TheKeno/Garage_Opener_Logicer/hardware/garage_controller/placement.png

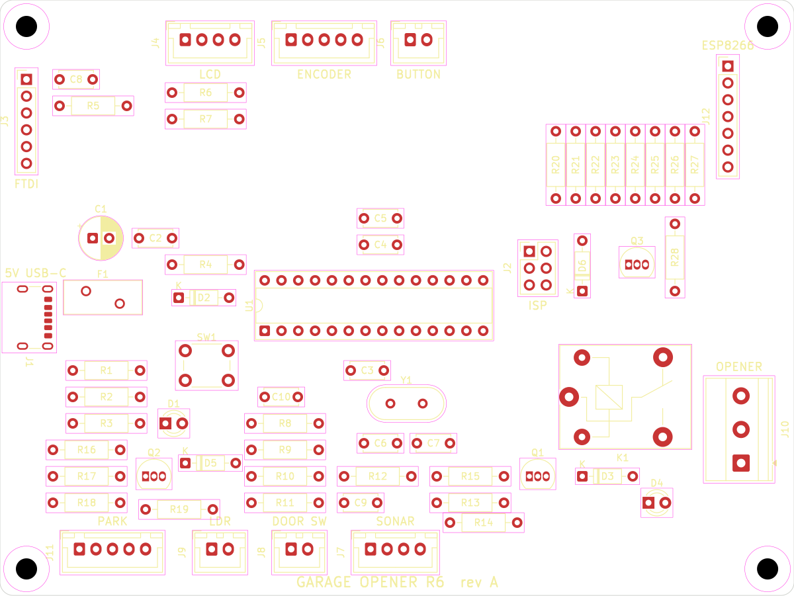
hardware/garage_controller/placement.png
