TheKeno/Garage_Opener_Logicer/hardware/garage_controller/garage_controller.pdf

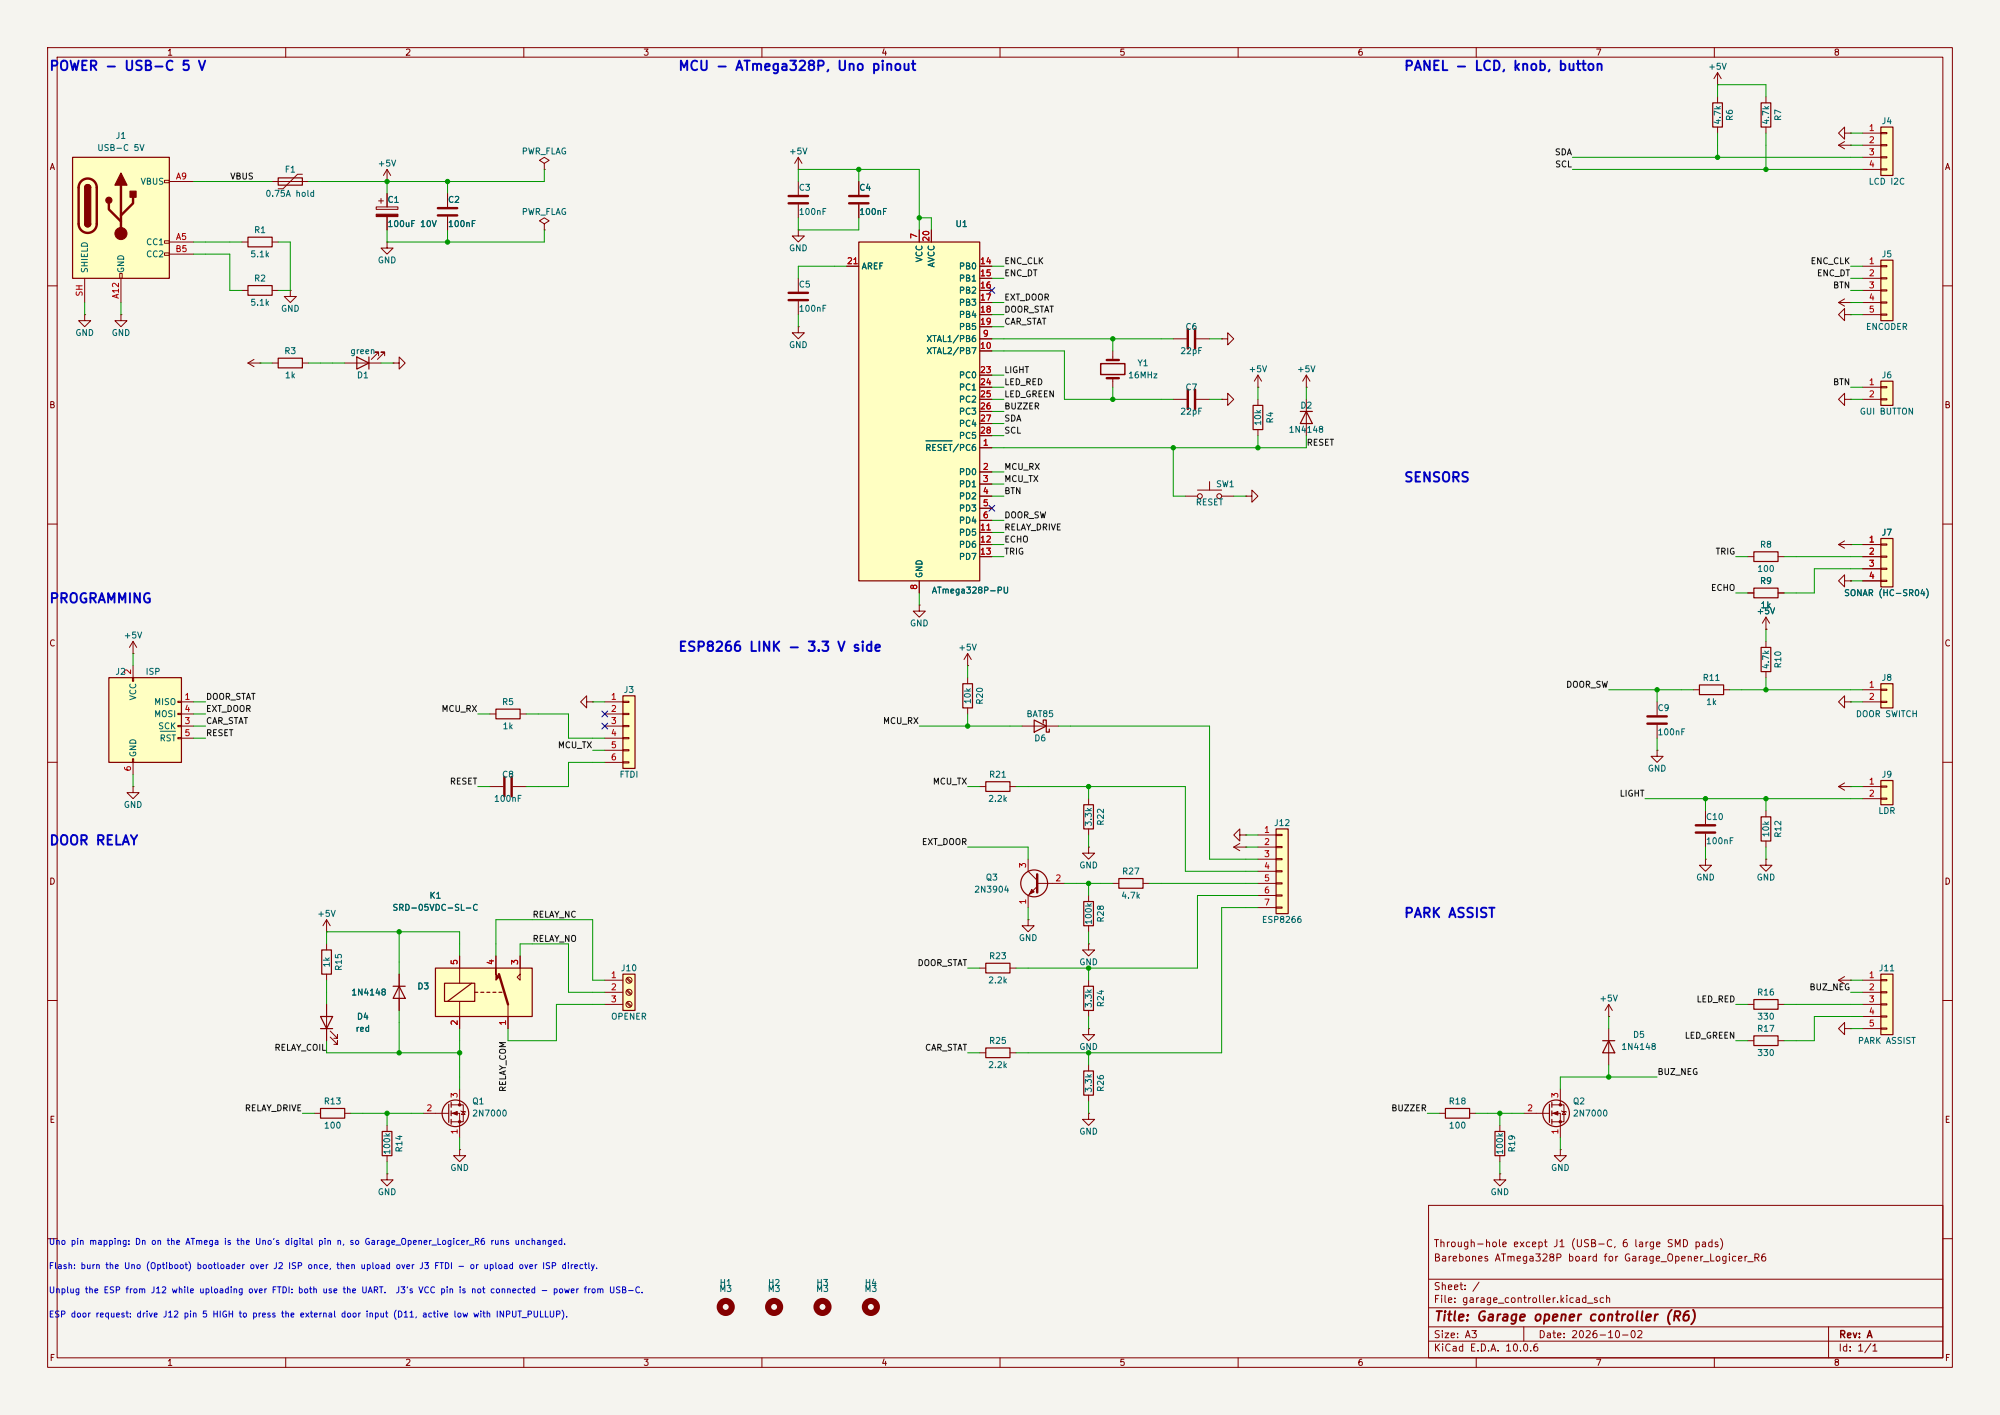
[picture p2: page 1]

Uno pin mapping: Dn on the ATmega is the Uno's digital pin n, so Garage_Opener_Logicer_R6 runs unchanged.

Flash: burn the Uno (Optiboot) bootloader over J2 ISP once, then upload over J3 FTDI - or upload over ISP directly.

Sheet: /
File: garage_controller.kicad_sch
Title: Garage opener controller (R6)

Unplug the ESP from J12 while uploading over FTDI: both use the UART. J3's VCC pin is not connected - power from USB-C. ESP door request: drive J12 pin 5 HIGH to press the external door input (D11, active low with INPUT_PULLUP).

Size: A3 | Rev: A | F Date: 2026-10-02
KiCad E.D.A. 10.0.6 | Id: 1/1
