TheKeno/Garage_Opener_Logicer/hardware/garage_controller/garage_controller.kicad_pcb

## KiCad design hardware/garage_controller/garage_controller.kicad_pcb (2026-10-02)

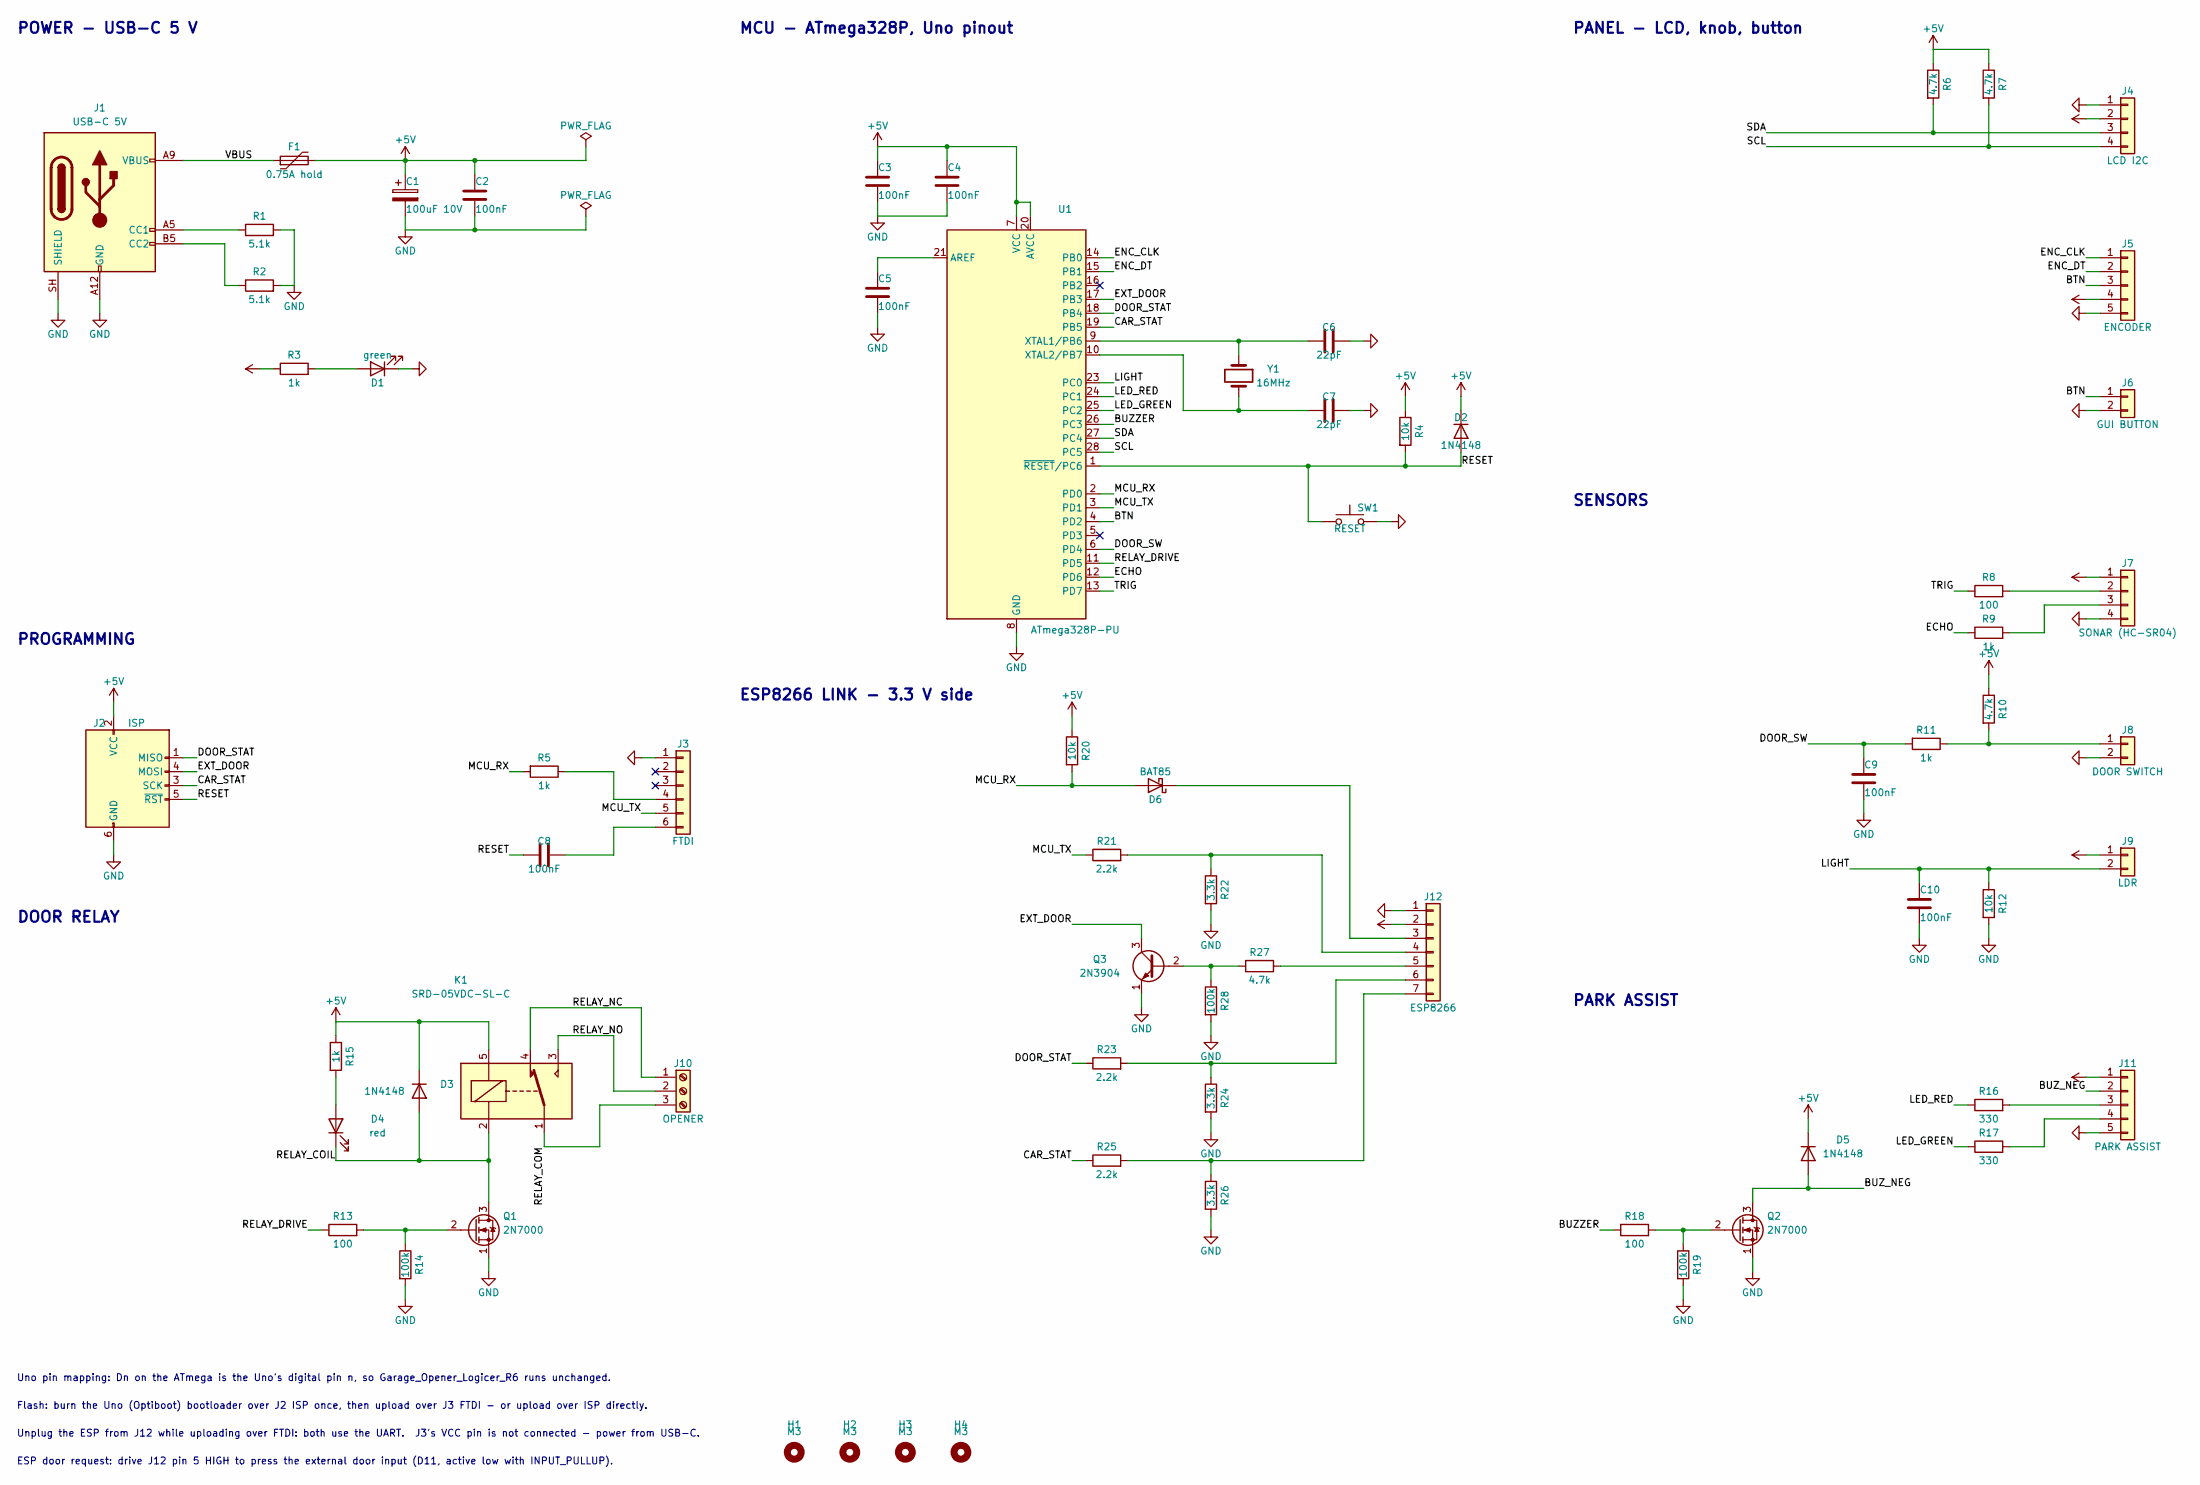
[picture p3: schematic garage_controller.kicad_sch, Garage opener controller (R6)]

Parts:
C1: 100uF 10V; CP_Radial_D6.3mm_P2.50mm
C2, C3, C4, C5, C8, C9, C10: 100nF; C_Disc_D5.0mm_W2.5mm_P5.00mm
C6, C7: 22pF; C_Disc_D5.0mm_W2.5mm_P5.00mm
D1: green; LED_D3.0mm
D2, D3, D5: 1N4148; D_DO-35_SOD27_P7.62mm_Horizontal
D4: red; LED_D3.0mm
D6: BAT85; D_DO-35_SOD27_P7.62mm_Horizontal
F1: 0.75A hold; Fuse_BelFuse_0ZRE0075FF_L11.5mm_W4.8mm
H1, H2, H3, H4: M3; MountingHole_3.2mm_M3
J1: USB-C 5V; USB_C_Receptacle_GCT_USB4125-xx-x_6P_TopMnt_Horizontal
J2: ISP; PinHeader_2x03_P2.54mm_Vertical
J3: FTDI; PinHeader_1x06_P2.54mm_Vertical
J4: LCD I2C; JST_XH_B4B-XH-A_1x04_P2.50mm_Vertical
J5: ENCODER; JST_XH_B5B-XH-A_1x05_P2.50mm_Vertical
J6: GUI BUTTON; JST_XH_B2B-XH-A_1x02_P2.50mm_Vertical
J7: SONAR (HC-SR04); JST_XH_B4B-XH-A_1x04_P2.50mm_Vertical
J8: DOOR SWITCH; JST_XH_B2B-XH-A_1x02_P2.50mm_Vertical
J9: LDR; JST_XH_B2B-XH-A_1x02_P2.50mm_Vertical
J10: OPENER; TerminalBlock_Phoenix_MKDS-1,5-3-5.08_1x03_P5.08mm_Horizont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
J11: PARK ASSIST; JST_XH_B5B-XH-A_1x05_P2.50mm_Vertical
J12: ESP8266; PinHeader_1x07_P2.54mm_Vertical
K1: SRD-05VDC-SL-C; Relay_SPDT_SANYOU_SRD_Series_Form_C
Q1, Q2: 2N7000; TO-92_Inline
Q3: 2N3904; TO-92_Inline
R1, R2: 5.1k; R_Axial_DIN0207_L6.3mm_D2.5mm_P10.16mm_Horizontal
R3, R5, R9, R11, R15: 1k; R_Axial_DIN0207_L6.3mm_D2.5mm_P10.16mm_Horizontal
R4, R12, R20: 10k; R_Axial_DIN0207_L6.3mm_D2.5mm_P10.16mm_Horizontal
R6, R7, R10, R27: 4.7k; R_Axial_DIN0207_L6.3mm_D2.5mm_P10.16mm_Horizontal
R8, R13, R18: 100; R_Axial_DIN0207_L6.3mm_D2.5mm_P10.16mm_Horizontal
R14, R19, R28: 100k; R_Axial_DIN0207_L6.3mm_D2.5mm_P10.16mm_Horizontal
R16, R17: 330; R_Axial_DIN0207_L6.3mm_D2.5mm_P10.16mm_Horizontal
R21, R23, R25: 2.2k; R_Axial_DIN0207_L6.3mm_D2.5mm_P10.16mm_Horizontal
R22, R24, R26: 3.3k; R_Axial_DIN0207_L6.3mm_D2.5mm_P10.16mm_Horizontal
SW1: RESET; SW_PUSH_6mm
U1: ATmega328P-PU; DIP-28_W7.62mm_Socket
Y1: 16MHz; Crystal_HC49-4H_Vertical

Connections:
+5V: C1.1, C2.1, C3.1, C4.1, D2.1 (K), D3.1 (K), D5.1 (K), F1.2, J2.2 (VCC), J4.2, J5.4, J7.1, J9.1, J11.1, J12.2, K1.5, R3.1, R4.1, R6.1, R7.1, R10.1, R15.1, R20.1, U1.7 (VCC), U1.20 (AVCC)
/BTN: J5.3, J6.1, U1.4 (PD2)
/BUZZER: R18.1, U1.26 (PC3)
/BUZ_NEG: D5.2 (A), J11.2, Q2.3 (D)
/CAR_STAT: J2.3 (SCK), R25.1, U1.19 (PB5)
/DOOR_STAT: J2.1 (MISO), R23.1, U1.18 (PB4)
/DOOR_SW: C9.1, R11.2, U1.6 (PD4)
/ECHO: R9.1, U1.12 (PD6)
/ENC_CLK: J5.1, U1.14 (PB0)
/ENC_DT: J5.2, U1.15 (PB1)
/EXT_DOOR: J2.4 (MOSI), Q3.3 (C), U1.17 (PB3)
/LED_GREEN: R17.1, U1.25 (PC2)
/LED_RED: R16.1, U1.24 (PC1)
/LIGHT: C10.1, J9.2, R12.1, U1.23 (PC0)
/MCU_RX: D6.2 (A), R5.2, R20.2, U1.2 (PD0)
/MCU_TX: J3.5, R21.1, U1.3 (PD1)
/RELAY_COIL: D3.2 (A), D4.1 (K), K1.2, Q1.3 (D)
/RELAY_COM: J10.3, K1.1
/RELAY_DRIVE: R13.1, U1.11 (PD5)
/RELAY_NC: J10.1, K1.4
/RELAY_NO: J10.2, K1.3
/RESET: C8.2, D2.2 (A), J2.5 (~RST), R4.2, SW1.1, U1.1 (~RESET/PC6)
/SCL: J4.4, R7.2, U1.28 (PC5)
/SDA: J4.3, R6.2, U1.27 (PC4)
/TRIG: R8.1, U1.13 (PD7)
/VBUS: F1.1, J1.A9 (VBUS), J1.B9 (VBUS)
GND: C1.2, C2.2, C3.2, C4.2, C5.2, C6.2, C7.2, C9.2, C10.2, D1.1 (K), J1.A12 (GND), J1.B12 (GND), J1.SH (SHIELD), J2.6 (GND), J3.1, J4.1, J5.5, J6.2, J7.4, J8.2, J11.5, J12.1, Q1.1 (S), Q2.1 (S), Q3.1 (E), R1.2, R2.2, R12.2, R14.2, R19.2, R22.2, R24.2, R26.2, R28.2, SW1.2, U1.8 (GND), U1.22 (GND)
unnamed: D1.2 (A), R3.2
unnamed: D4.2 (A), R15.2
unnamed: D6.1 (K), J12.3
unnamed: J1.A5 (CC1), R1.1
unnamed: J1.B5 (CC2), R2.1
unnamed: J3.4, R5.1
unnamed: C8.1, J3.6
unnamed: J7.2, R8.2
unnamed: J7.3, R9.2
unnamed: J8.1, R10.2, R11.1
unnamed: J11.3, R16.2
unnamed: J11.4, R17.2
unnamed: J12.4, R21.2, R22.1
unnamed: J12.5, R27.1
unnamed: J12.6, R23.2, R24.1
unnamed: J12.7, R25.2, R26.1
unnamed: Q1.2 (G), R13.2, R14.1
unnamed: Q2.2 (G), R18.2, R19.1
unnamed: Q3.2 (B), R27.2, R28.1
unnamed: C5.1, U1.21 (AREF)
unnamed: C6.1, U1.9 (XTAL1/PB6), Y1.1
unnamed: C7.1, U1.10 (XTAL2/PB7), Y1.2

Notes on the sheet:
MCU - ATmega328P, Uno pinout
Unplug the ESP from J12 while uploading over FTDI: both use the UART. J3's VCC pin is not connected - power from USB-C.
Uno pin mapping: Dn on the ATmega is the Uno's digital pin n, so Garage_Opener_Logicer_R6 runs unchanged.
SENSORS
PROGRAMMING
PANEL - LCD, knob, button
Flash: burn the Uno (Optiboot) bootloader over J2 ISP once, then upload over J3 FTDI - or upload over ISP directly.
ESP door request: drive J12 pin 5 HIGH to press the external door input (D11, active low with INPUT_PULLUP).
PARK ASSIST
DOOR RELAY
ESP8266 LINK - 3.3 V side
POWER - USB-C 5 V

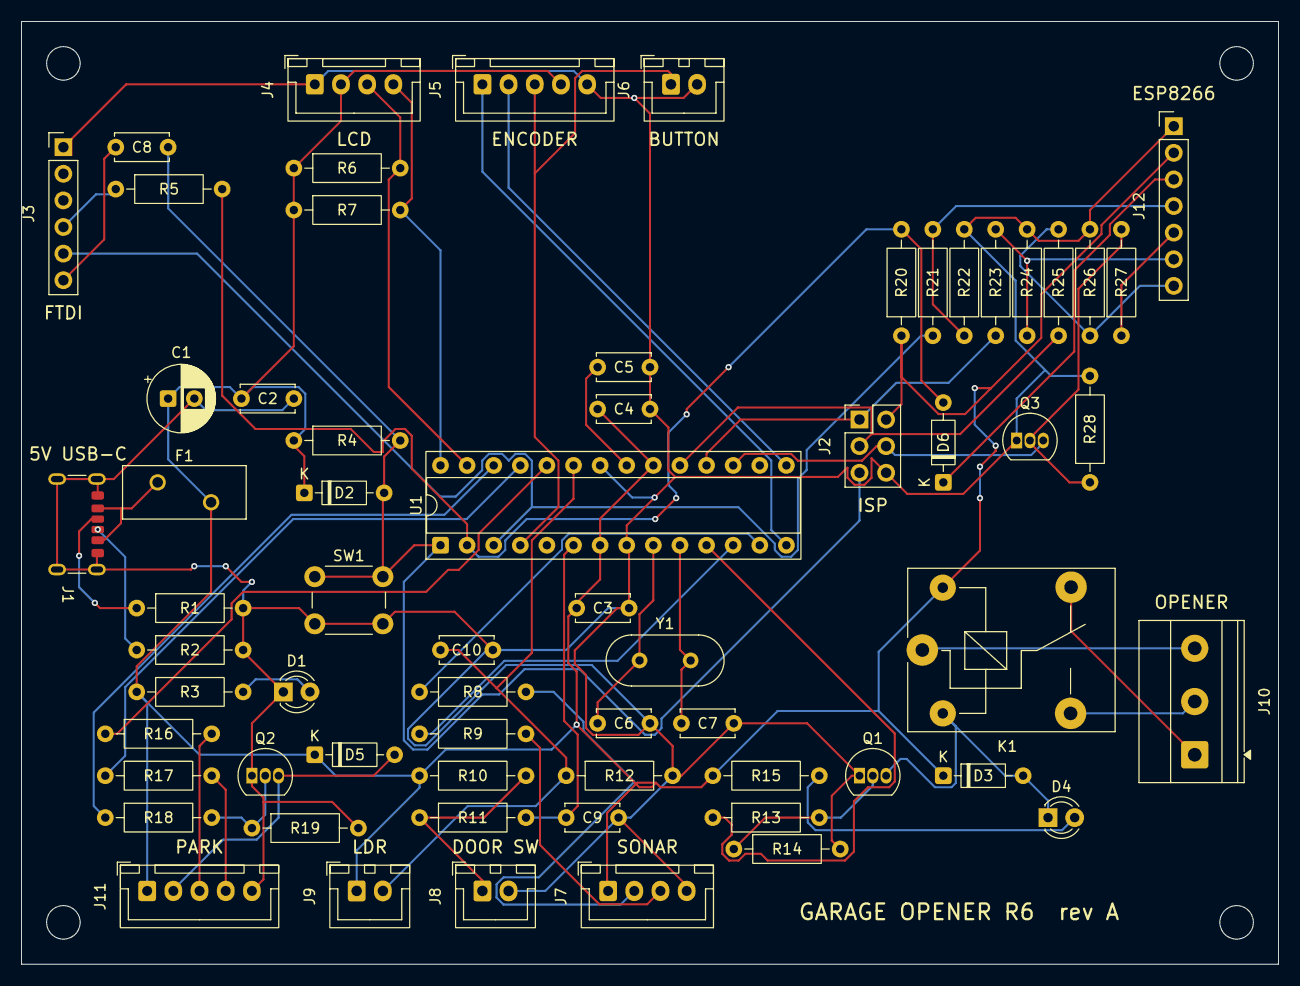
[picture p4: board garage_controller.kicad_pcb from above]

Board: 2 copper layers, 120.0 x 90.0 mm, 68 parts (0 on the bottom side), 49 nets.
