TheKeno/Garage_Opener_Logicer/Garage_Opener_Logicer_R5/Garage_Opener_Logicer_R5.ino

// Libraries
#include "Arduino.h"
#include "Button.h"

class DistanceSensor {
public:
	DistanceSensor(int trigger, int sensor) : trigger_pin(trigger), sensor_pin(sensor) {
	}
	float get_distance() {
		digitalWrite(trigger_pin, LOW);
		delayMicroseconds(2);
		
		digitalWrite(trigger_pin, HIGH);
		delayMicroseconds(10);
		digitalWrite(trigger_pin, LOW);

		unsigned long duration = pulseIn(sensor_pin, HIGH);

		return duration * SOUND_VELOCITY/2;
	}

private:
	const float SOUND_VELOCITY = 0.034;

	int trigger_pin;
	int sensor_pin;
};

enum STATES {
	STATE_IDLE,
	STATE_WAIT_FOR_DARKNESS,
	STATE_WAIT_FOR_SECOND_SIGNAL,
	STATE_OPEN_DOOR,
	STATE_CLOSE_DOOR,
};

struct StateData {
	STATES current_state;
	unsigned long entered_state_time;
};

const int trigPin = D6;
const int echoPin = D5;
const int lightPin = A0;
const int microswitchPin = D3;
const int doorPin = D4;


const int LIGHT_LEVEL_THRESHOLD = 400;
const int LIGHT_OFF_THRESHOLD = 700;
const int LIGHT_TIMEOUT = 5000;
const int DOOR_DELAY = 10000;
const int CAR_DISTANCE = 100;

Button microSwitch(microswitchPin);
DistanceSensor ultraSensor(trigPin, echoPin);


bool is_car_inside() {
	int distance = ultraSensor.get_distance();
	if(distance < CAR_DISTANCE) {
		return true;
	}

	return false;
}

bool is_door_closed() {
	return microSwitch.released();
}

void send_door_signal() {
	digitalWrite(doorPin, LOW);
	delay(10);
	digitalWrite(doorPin, HIGH);
	delay(500);
	digitalWrite(doorPin, LOW);
}

void switch_state(StateData* data, STATES new_state) {
    data->current_state = new_state;
    data->entered_state_time = millis();

    switch(new_state) {
        case STATE_OPEN_DOOR:
            Serial.println("State switch: OPEN DOOR");
            send_door_signal();
            break;

        case STATE_CLOSE_DOOR:
            Serial.println("State switch: CLOSE DOOR");
            send_door_signal();
            break;
        
        case STATE_IDLE:
            Serial.println("State switch: IDLE");
            break;

        case STATE_WAIT_FOR_DARKNESS:
            Serial.println("State switch: WAIT_FOR_DARKNESS");
            break;

        case STATE_WAIT_FOR_SECOND_SIGNAL:
            Serial.println("State switch: WAIT_FOR_SECOND_SIGNAL");
            break;

        default:
            break;
    }
}

void update_idle(StateData* data) {
	if(!is_car_inside())
		return;

	int light_level = analogRead(lightPin);
	if(light_level < LIGHT_LEVEL_THRESHOLD) {
		if(is_door_closed()) {
			switch_state(data, STATE_WAIT_FOR_SECOND_SIGNAL);
		} else {
			switch_state(data, STATE_CLOSE_DOOR);
		}
	}
}

void update_wait_for_darkness(StateData* data) {
	if(millis() > data->entered_state_time + LIGHT_TIMEOUT) {
		switch_state(data, STATE_IDLE);
		return;
	}

	int light_level = analogRead(lightPin);
	if(light_level > LIGHT_OFF_THRESHOLD) {
		switch_state(data, STATE_WAIT_FOR_SECOND_SIGNAL);
	}
}

void update_wait_for_second_signal(StateData* data) {
	if(millis() > data->entered_state_time + LIGHT_TIMEOUT) {
		switch_state(data, STATE_IDLE);
		return;
	}

	int light_level = analogRead(lightPin);
	if(light_level < LIGHT_LEVEL_THRESHOLD) {
		if(is_door_closed()) {
			switch_state(data, STATE_OPEN_DOOR);
		}
	}
}

void update_open_door(StateData* data) {
	if(millis() > data->entered_state_time + DOOR_DELAY) {
		switch_state(data, STATE_IDLE);
		return;
	}
}

void update_close_door(StateData* data) {
	if(millis() > data->entered_state_time + DOOR_DELAY) {
		switch_state(data, STATE_IDLE);
		return;
	}
}

void update(StateData* data) {
	microSwitch.read();

	switch(data->current_state) {
		case STATE_IDLE:
			update_idle(data);
			break;

		case STATE_WAIT_FOR_DARKNESS:
			update_wait_for_darkness(data);
			break;
		
		case STATE_WAIT_FOR_SECOND_SIGNAL:
			update_wait_for_second_signal(data);
			break;

		case STATE_OPEN_DOOR:
			update_open_door(data);
			break;

		case STATE_CLOSE_DOOR:
			update_close_door(data);
			break;
	}

	delay(10);
}


StateData data;
unsigned long time_of_last_print = 0;

void setup() {
	data.current_state = STATE_IDLE;

	pinMode(trigPin, OUTPUT);
	pinMode(echoPin, INPUT);
	pinMode(lightPin, INPUT);
	pinMode(doorPin, OUTPUT);
	pinMode(microswitchPin, INPUT);

	microSwitch.begin();
	Serial.begin(9600);
	time_of_last_print = millis();
}



void loop() {
    if(millis() > time_of_last_print + 5000) {
        Serial.print("Distance: ");
        Serial.println(ultraSensor.get_distance());

        Serial.print("Light level: ");
        Serial.println(analogRead(lightPin));

        Serial.print("Microswitch: ");
        Serial.println(microSwitch.pressed());

        time_of_last_print = millis();
    }

    update(&data);
}
