TheKeno/Garage_Opener_Logicer/Garage_Opener_Logicer_R6/LightPulseSensor.cpp

#include "LightPulseSensor.h"
#include "Arduino.h"

LightPulseSensor::LightPulseSensor(int pin, unsigned long pulse_timeout, int upper_threshold, int lower_threshold) 
	: pin(pin)
	, pulse_timeout(pulse_timeout)
	, upper_threshold(upper_threshold)
	, lower_threshold(lower_threshold) {}

void LightPulseSensor::begin() {
	int value = analogRead(pin);
	for(int i = 0; i < NUM_SAMPLES; ++i) {
		samples[i] = value;
	}
	average = value;
	time_since_last_sample = millis();
}

bool LightPulseSensor::did_pulse() {
	if(detected_pulse) {
		detected_pulse = false;
		return true;
	}

	return false;
}

void LightPulseSensor::update(bool detect_pulses) {
	int value = analogRead(pin);

	if(millis() - time_since_last_sample >= TIME_BETWEEN_SAMPLES) {
		average = 0;
		for(int i = LightPulseSensor::NUM_SAMPLES - 1; i > 0; --i) {
			samples[i] = samples[i - 1];
			average += samples[i];
		}
		samples[0] = value;
		average += value;
		average /= NUM_SAMPLES;

		time_since_last_sample = millis();
	}

	if(!detect_pulses) {
		// Hold the detector at rest so it cannot come back mid-pulse, and drop
		// anything it had latched.
		seeking_high_value = true;
		stayed_on = false;
		detected_pulse = false;
		return;
	}

	if(seeking_high_value) {
		if(value >= average + upper_threshold) {
			seeking_high_value = false;
			detected_pulse = false;
			time_of_max_value = millis();
		}
	} else {
		// Too long to be a flash. Keep waiting for the light to go off anyway:
		// re-arming while it is still on would turn the eventual switch-off
		// into a pulse of its own.
		if(millis() - time_of_max_value >= pulse_timeout) {
			stayed_on = true;
		}
		if(value <= average + lower_threshold) {
			seeking_high_value = true;
			detected_pulse = !stayed_on;
			stayed_on = false;
		}
	}
}
