TheKeno/Garage_Opener_Logicer/(commit log)

2025-10-25 Added labels to LCD print
2025-10-25 Fixed button usage
2025-10-26 pin changes
2025-10-26 First try at light pulse sensor
2025-10-26 Use light pulse sensor
2025-10-26 Fixing button issues
2025-10-26 changed board to arduino. Does not compile with that board
2025-10-26 Replaced printf on lcd with snprintf+print
    [Garage_Opener_Logicer_R6.ino]
2025-10-26 Fixed config values under 0
    [Garage_Opener_Logicer_R6.ino]
2025-10-27 Added average light level sampling to light pulse sensor
2025-10-28 Moved constans and pin setup to config.h
2025-10-29 Made distance sensor only run once per second
2025-11-02 added pin configs
2026-09-01 Claude review fixes and improvements
    [DistanceSensor.cpp, DistanceSensor.h, Garage_Opener_Logicer_R6.ino, LightPulseSensor.cpp, LightPulseSensor.h, config.h]
2026-09-02 Added ESP/PC control interface over serial, cleaned up old debug prints
2026-09-03 Replaced config button with encoder
    [Garage_Opener_Logicer_R6.ino, config.h]
2026-09-03 Added polling interval to distance sensor
2026-10-01 Sim, tests, two fixed bugs
    [Garage_Opener_Logicer_R6.ino, LightPulseSensor.cpp, LightPulseSensor.h, check.h, garage_sim.cpp]
2026-10-02 added kicad files
    [bom.csv, garage_controller.kicad_pcb, garage_controller.kicad_sch]
